FrankieDedo/KSP-Commander-Console/Schematics/KSPCC_circuit.pdf

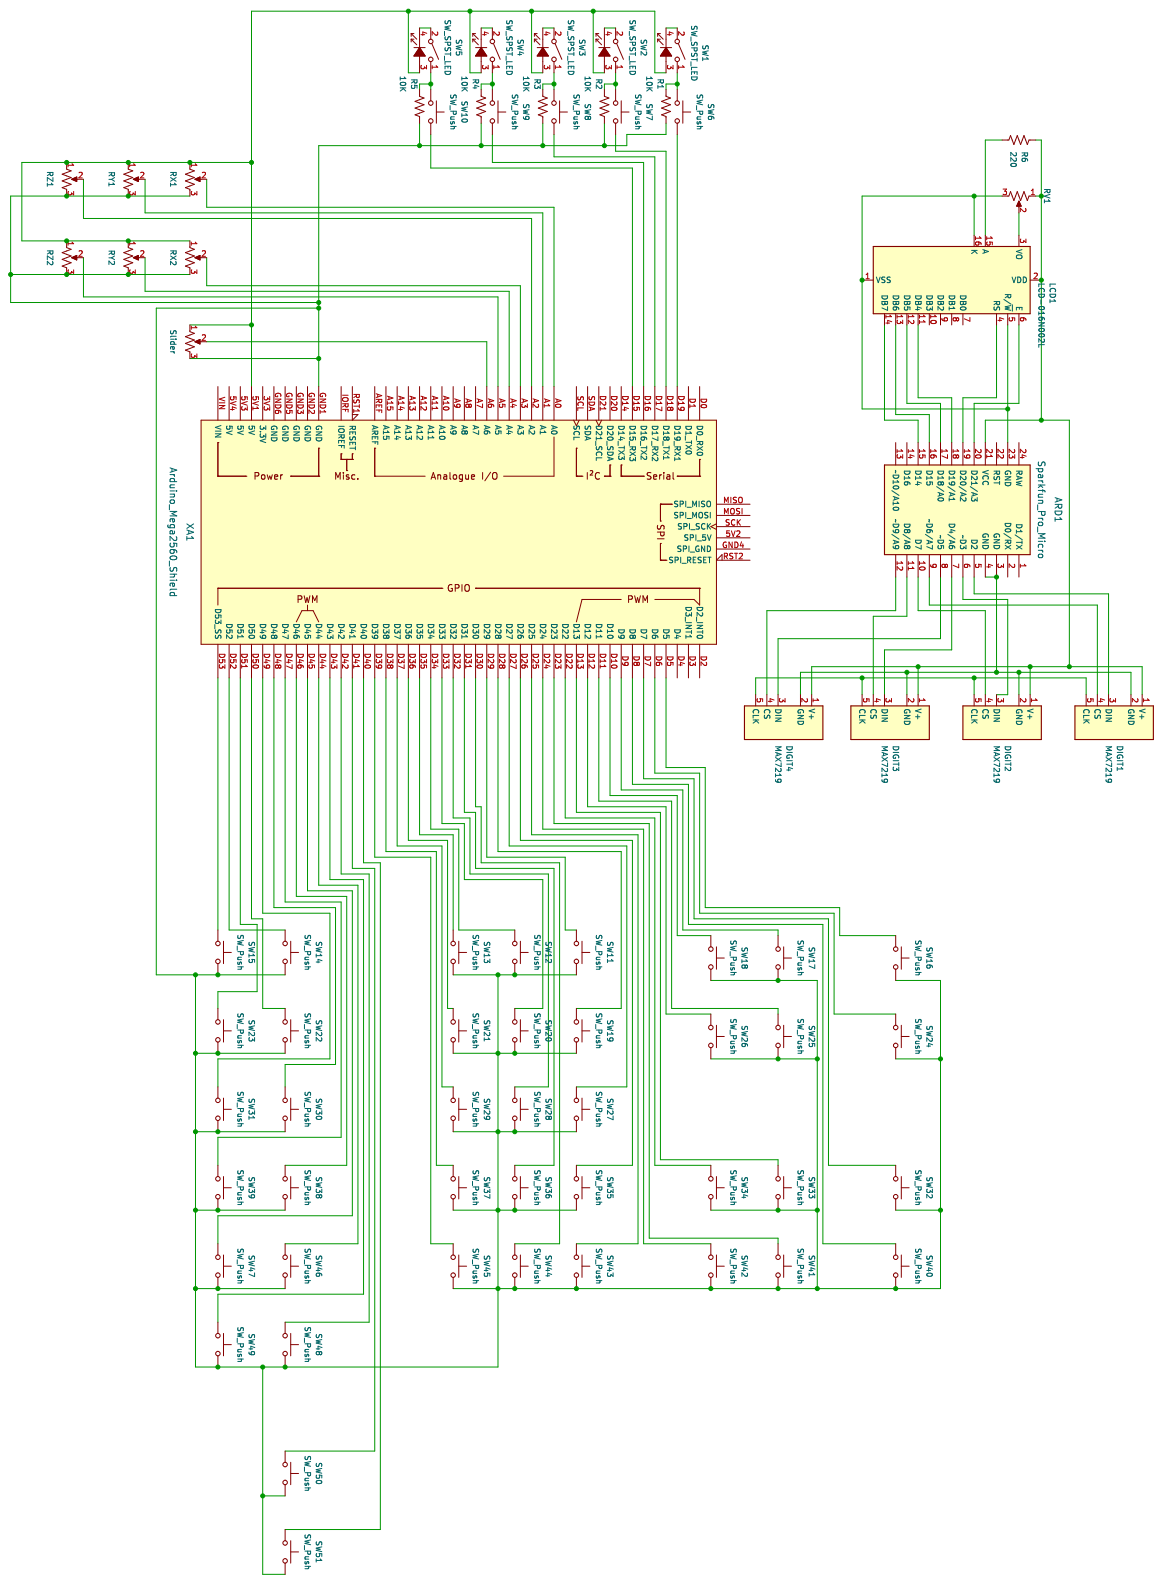
[picture p1: page 1]
