FrankieDedo/KSP-Commander-Console/Schematics/KSP.kicad_sch

## KiCad design Schematics/KSP.kicad_sch (2023-02-04)

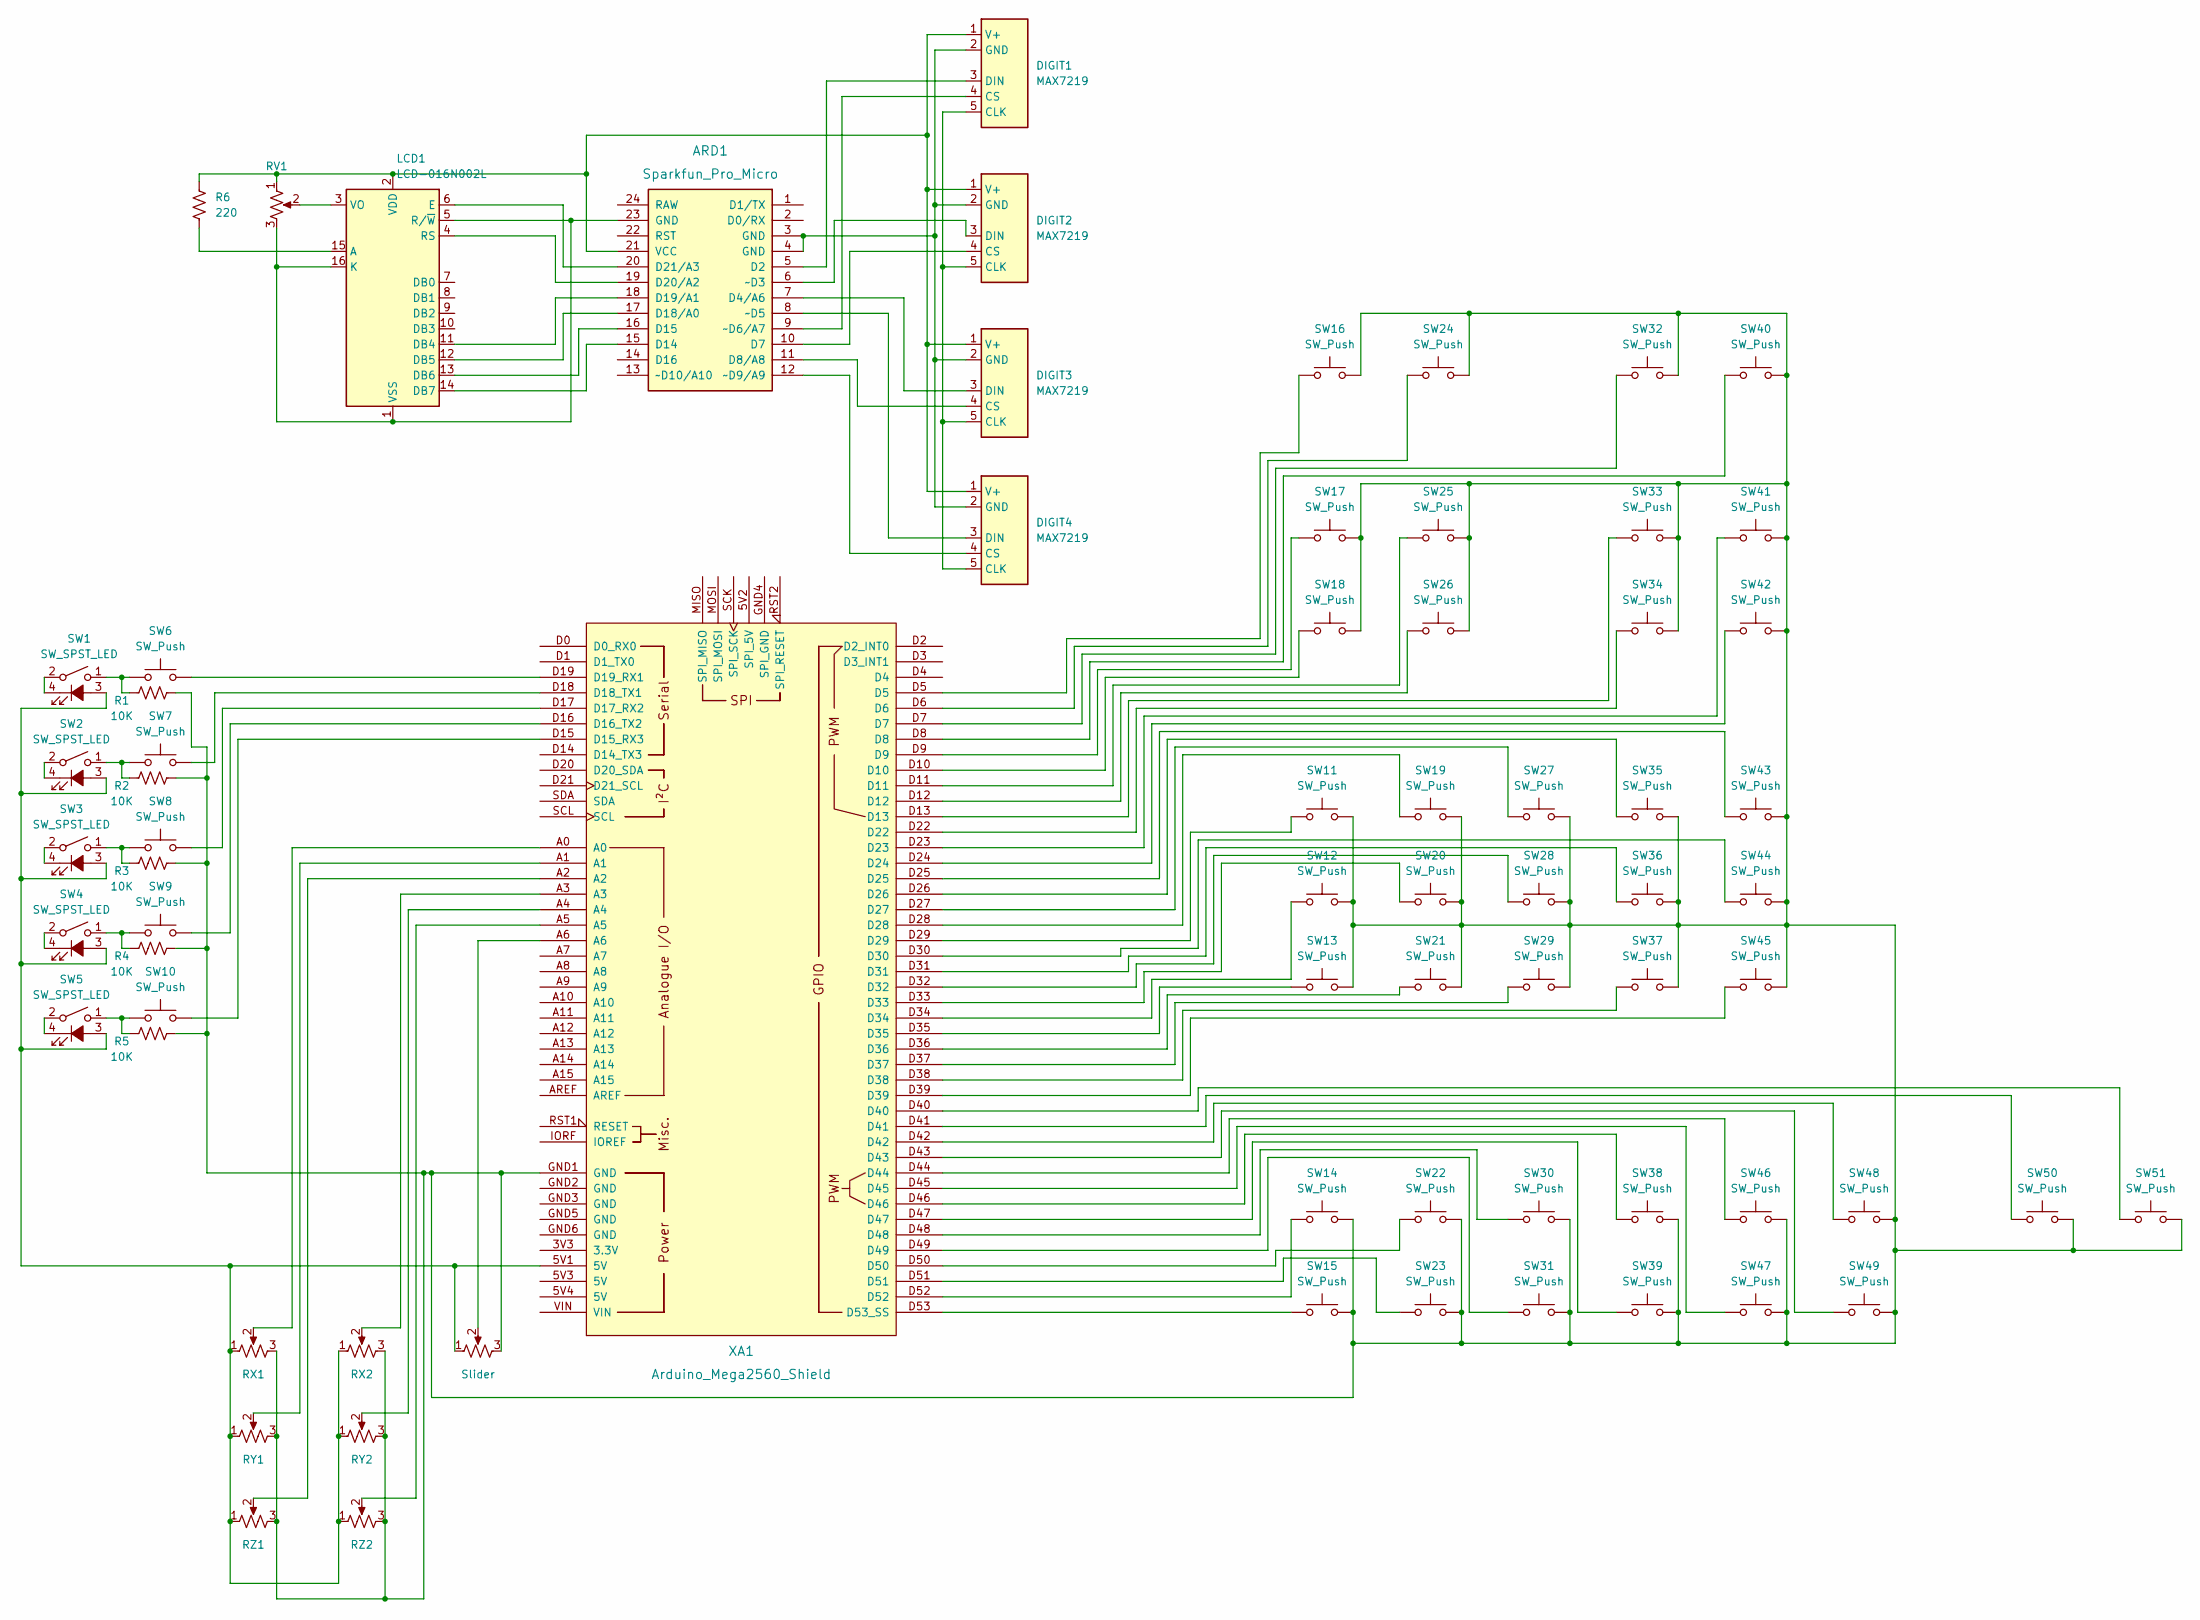
[picture p2: schematic KSP.kicad_sch]

Parts:
ARD1: Sparkfun_Pro_Micro
DIGIT1, DIGIT2, DIGIT3, DIGIT4: MAX7219
LCD1: LCD-016N002L
R1, R2, R3, R4, R5: 10K
R6: 220
RV1: R_Potentiometer_US
RX1, RX2: R_Potentiometer_US
RY1, RY2: R_Potentiometer_US
RZ1, RZ2: R_Potentiometer_US
SW1, SW2, SW3, SW4, SW5: SW_SPST_LED
SW6, SW7, SW8, SW9, SW10, SW11, SW12, SW13, SW14, SW15, SW16, SW17, SW18, SW19, SW20, SW21, SW22, SW23, SW24, SW25, SW26, SW27, SW28, SW29, SW30, SW31, SW32, SW33, SW34, SW35, SW36, SW37, SW38, SW39, SW40, SW41, SW42, SW43, SW44, SW45, SW46, SW47, SW48, SW49, SW50, SW51: SW_Push
Slider: R_Potentiometer_US
XA1: Arduino_Mega2560_Shield

Connections:
unnamed: ARD1.3 (GND), ARD1.4 (GND), DIGIT1.2 (GND), DIGIT2.2 (GND), DIGIT3.2 (GND), DIGIT4.2 (GND)
unnamed: ARD1.5 (D2), DIGIT1.3 (DIN)
unnamed: ARD1.6 (~D3), DIGIT2.3 (DIN)
unnamed: ARD1.7 (D4/A6), DIGIT3.3 (DIN)
unnamed: ARD1.8 (~D5), DIGIT4.3 (DIN)
unnamed: ARD1.9 (~D6/A7), DIGIT1.4 (CS)
unnamed: ARD1.10 (D7), DIGIT2.4 (CS)
unnamed: ARD1.11 (D8/A8), DIGIT3.4 (CS)
unnamed: ARD1.12 (~D9/A9), DIGIT4.4 (CS)
unnamed: ARD1.15 (D14), LCD1.14 (DB7)
unnamed: ARD1.16 (D15), LCD1.13 (DB6)
unnamed: ARD1.17 (D18/A0), LCD1.12 (DB5)
unnamed: ARD1.18 (D19/A1), LCD1.11 (DB4)
unnamed: ARD1.19 (D20/A2), LCD1.4 (RS)
unnamed: ARD1.20 (D21/A3), LCD1.6 (E)
unnamed: ARD1.21 (VCC), DIGIT1.1 (V+), DIGIT2.1 (V+), DIGIT3.1 (V+), DIGIT4.1 (V+), LCD1.2 (VDD), R6.1, RV1.1
unnamed: ARD1.23 (GND), LCD1.1 (VSS), LCD1.5 (R/~W), LCD1.16 (K), RV1.3
unnamed: DIGIT1.5 (CLK), DIGIT2.5 (CLK), DIGIT3.5 (CLK), DIGIT4.5 (CLK)
unnamed: LCD1.3 (VO), RV1.2
unnamed: LCD1.15 (A), R6.2
unnamed: R1.1, SW1.1, SW6.2
unnamed: R1.2, R2.2, R3.2, R4.2, R5.2, RX1.3, RX2.3, RY1.3, RY2.3, RZ1.3, RZ2.3, SW11.1, SW12.1, SW13.1, SW14.1, SW15.1, SW16.2, SW17.2, SW18.2, SW19.1, SW20.1, SW21.1, SW22.1, SW23.1, SW24.2, SW25.2, SW26.2, SW27.1, SW28.1, SW29.1, SW30.1, SW31.1, SW32.2, SW33.2, SW34.2, SW35.1, SW36.1, SW37.1, SW38.1, SW39.1, SW40.2, SW41.2, SW42.2, SW43.1, SW44.1, SW45.1, SW46.1, SW47.1, SW48.1, SW49.1, SW50.2, SW51.2, Slider.3, XA1.GND1 (GND)
unnamed: R2.1, SW2.1, SW7.2
unnamed: R3.1, SW3.1, SW8.2
unnamed: R4.1, SW4.1, SW9.2
unnamed: R5.1, SW5.1, SW10.2
unnamed: RX1.1, RX2.1, RY1.1, RY2.1, RZ1.1, RZ2.1, SW1.3 (K), SW2.3 (K), SW3.3 (K), SW4.3 (K), SW5.3 (K), Slider.1, XA1.5V1 (5V)
unnamed: RX1.2, XA1.A0
unnamed: RX2.2, XA1.A3
unnamed: RY1.2, XA1.A1
unnamed: RY2.2, XA1.A4
unnamed: RZ1.2, XA1.A2
unnamed: RZ2.2, XA1.A5
unnamed: SW1.2, SW1.4 (A)
unnamed: SW2.2, SW2.4 (A)
unnamed: SW3.2, SW3.4 (A)
unnamed: SW4.2, SW4.4 (A)
unnamed: SW5.2, SW5.4 (A)
unnamed: SW6.1, XA1.D19 (D19_RX1)
unnamed: SW7.1, XA1.D18 (D18_TX1)
unnamed: SW8.1, XA1.D17 (D17_RX2)
unnamed: SW9.1, XA1.D16 (D16_TX2)
unnamed: SW10.1, XA1.D15 (D15_RX3)
unnamed: SW11.2, XA1.D29
unnamed: SW12.2, XA1.D34
unnamed: SW13.2, XA1.D35
unnamed: SW14.2, XA1.D52
unnamed: SW15.2, XA1.D53 (D53_SS)
unnamed: SW16.1, XA1.D5
unnamed: SW17.1, XA1.D9
unnamed: SW18.1, XA1.D10
unnamed: SW19.2, XA1.D28
unnamed: SW20.2, XA1.D33
unnamed: SW21.2, XA1.D36
unnamed: SW22.2, XA1.D50
unnamed: SW23.2, XA1.D51
unnamed: SW24.1, XA1.D6
unnamed: SW25.1, XA1.D11
unnamed: SW26.1, XA1.D12
unnamed: SW27.2, XA1.D27
unnamed: SW28.2, XA1.D32
unnamed: SW29.2, XA1.D37
unnamed: SW30.2, XA1.D48
unnamed: SW31.2, XA1.D49
unnamed: SW32.1, XA1.D7
unnamed: SW33.1, XA1.D13
unnamed: SW34.1, XA1.D22
unnamed: SW35.2, XA1.D26
unnamed: SW36.2, XA1.D31
unnamed: SW37.2, XA1.D38
unnamed: SW38.2, XA1.D46
unnamed: SW39.2, XA1.D47
unnamed: SW40.1, XA1.D8
unnamed: SW41.1, XA1.D23
unnamed: SW42.1, XA1.D24
unnamed: SW43.2, XA1.D25
unnamed: SW44.2, XA1.D30
unnamed: SW45.2, XA1.D39
unnamed: SW46.2, XA1.D44
unnamed: SW47.2, XA1.D45
unnamed: SW48.2, XA1.D42
unnamed: SW49.2, XA1.D43
unnamed: SW50.1, XA1.D41
unnamed: SW51.1, XA1.D40
unnamed: Slider.2, XA1.A6
